Fmarinn-123/HALO/ESMRMB_poster 2.pdf

OBJECTIVES

# HALO: AN ULTRA LOW COST GRADIENT AMPLIFIER FOR LOW FIELD MRI

INTRODUCTION

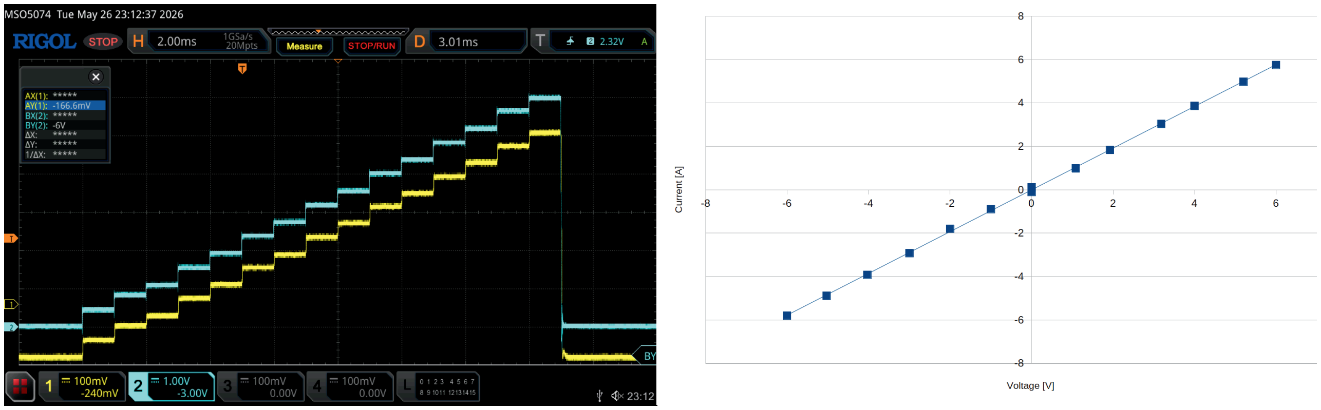
[picture p1: figure]

RESULTS

Felipe Marín | Belén Bravo-Kunz | Clemente Soza
1,2 | 1,2 | 1,2
Carlos Milovic | Cristian Tejos | Pablo Irarrázaval
1,2 | 1,2,3 | 1,2,3,4
Department of Electrical Engineering, Pontificia Universidad Católica de Chile

1
Biomedical Imaging Center, Pontificia Universidad Católica de Chile

2
Millennium Institute for Intelligent Healthcare Engineering, Pontificia Universidad Católica de Chile

3
Institute for Biological and Medical Engineering, Pontificia Universidad Católica de Chile

4

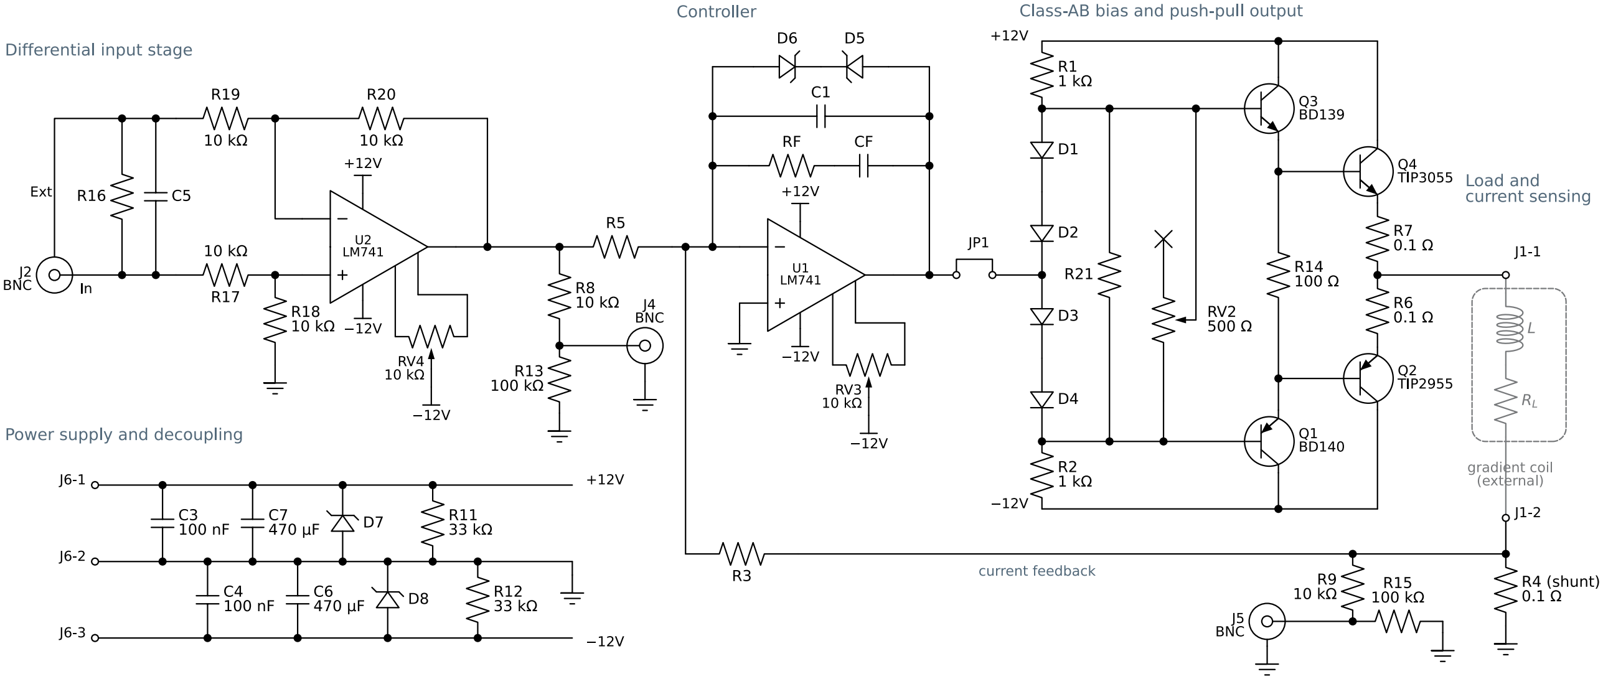
[picture p2: figure]
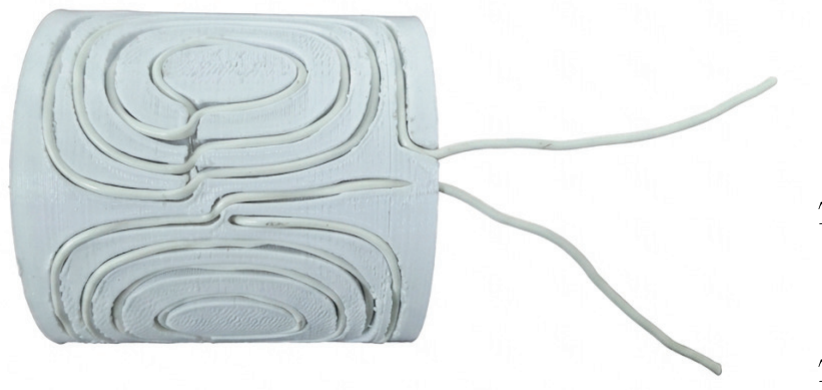
[picture p3: figure]

Acknowledgements. This study was supported by ANID – Millennium Science Initiative Program ICN2021_004 (iHEALTH) and Fondecit 1231535

Halbach low-field scanners lower cost, but accessible systems also require affordable, reproducible electronics.
Commercial gradient amplifiers exceed the power and cost needs of small, passively cooled coils. Open-source designs (e.g., OSII [1]) target higher currents and add monitoring and protection stages,
increasing cost and complexity.
Aim: a gradient amplifier under USD 100/channel that is simple, reproducible, locally manufacturable, and

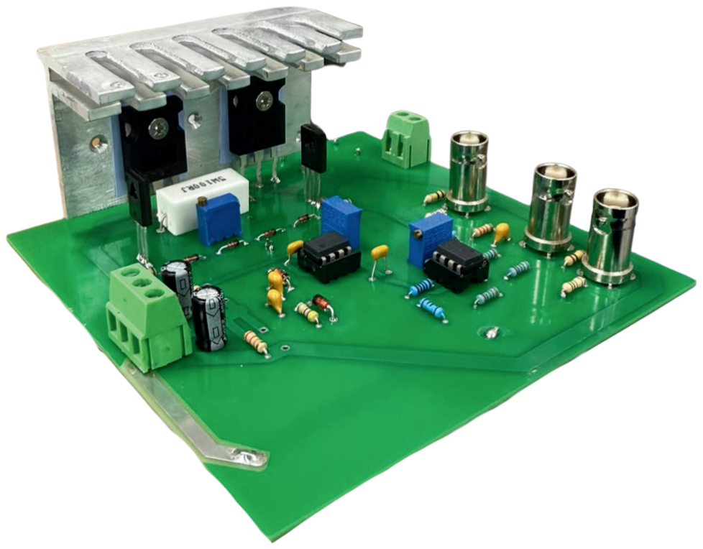
[picture p4: figure]

suited to low-field, small-FOV MRI. | Figure 1: Single-channel amplifier circuit
METHODS | RESULTS

Design requirements and architecture
- Load: Gradient coils (0.2 Ω, 10 μH, 5 mT/(m·A)) driven with trapezoids up
to ±6 A and 0.5 ms rise/fall times.
- Supply: ±12 V from two 12 V, 7 Ah batteries, avoiding ground noise, switching EMI and ripple.
- Controller: Closed-loop PI (UA741CP op-amp) following Evetts and Conradi [2], ensuring zero steady-state error on the RL load.
- Power stage: Class AB adapted from Self [3], providing symmetric bidirectional current, low distortion and low output impedance (Figs. 2–3).

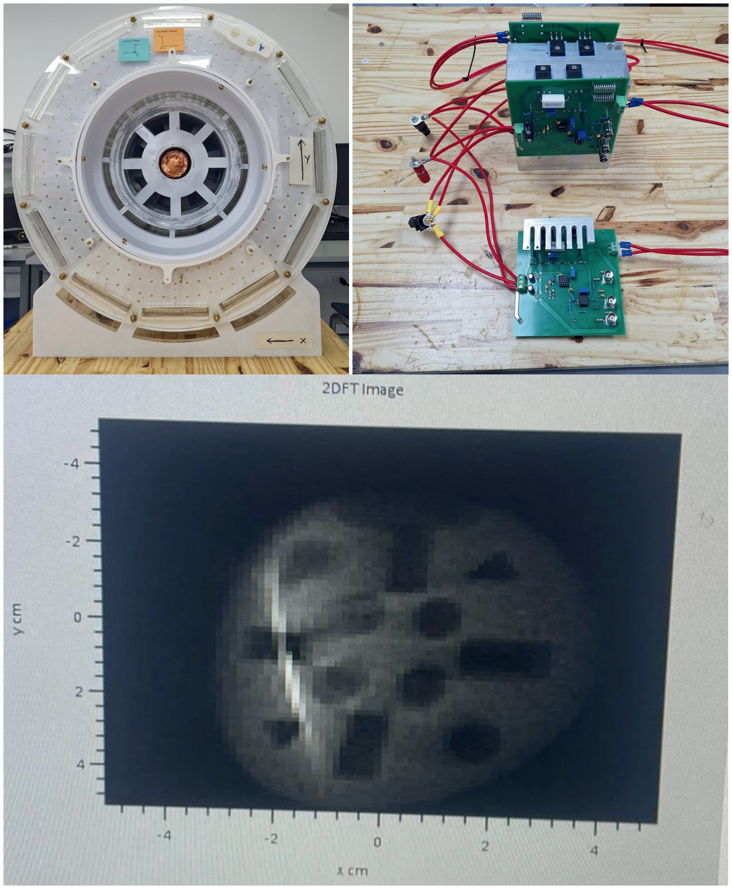
[picture p5: figure]

CONCLUSIONS

REFERENCES

[1] D. H. de Gans, Gradient Amplifier Design, Open Source Imaging Initiative design document, 2020.
[2] N. Evetts and M. S. Conradi, “Low-cost gradient amplifiers for small MRI systems,” Journal of Magnetic Resonance, vol. 335, 107127, 2022.
[3] D. Self, Audio Power Amplifier Design, 6th ed., Focal Press, 2013.

Contact: felipemarinegrete@uc.cl

Poster N° PG104

Power stage
- Current boost: Darlington class AB stage amplifying the op-amp's ~20 mA output.
- Output transistors: TIP3055/TIP2955 (15 A, 90 W) driven by a BD139/BD140 pair.
- Bias: Four 1N4148 diodes, adjusted with RV2.
Controller tuning
- Transfer functions: Controller Eq. (1) yielding closed loop Eq. (2), reduced to Eq. (3) when C R = L/R . f f L
- Bandwidth: At least 10 kHz, targeted for tracking 0.5 ms ramps.
- Closed-loop design tool on github repository (see QR code).

Figure 2: Implemented circuit schematic

Figure 4: Stepped current response (Cyan: voltage input; yellow: measured output current) and current-voltage linear fit

Linearity: Tested
with current
staircases from 0 to
±6 A (Fig. 4).

Figure 7: 50 mT ERNIE setup and two oil tubes results

Figure 6: 46 mT Halbach setup and oil phantom results

Rise time: Measured at 0.06 ms for a 6 A step (30 mT/m) against a 0.5 ms target (Fig. 5), enabling faster switching, shorter readouts and less offresonance.

Construction: Built from local through-hole parts on a simplified PCB for about USD 70/channel (about USD 210 for 3 axes).

MRI integration: Tested with three amplifiers on a shared ±12 V battery pack driving the x/y/z coils of an in-house 46 mT Halbach scanner, imaging an oil phantom (Fig. 6).

ERNIE: Integrated into the CAMERA-IMAGINE educational toolkit (piloted at the
ESMRMB | 2025 | Workshop), | yielding
gradient-encoded phantom images (Fig. 7) and showing readiness for open educational platforms.

Limitation: Tuning of the PI controller required for each load and target bandwidth; a design tool for choosing the parameters is available on GitHub, together with the rest of the project files (see QR code).

Figure 5: Circuit response to a 6 A step with 0.06 ms rise time.

Figure 3: Gradient coil used as circuit load and the closed-loop control equations

Costs under USD 100/channel for low-field MRI.
Provides linear current control, delivering ±6 A at 0.1 A/μs (500 T/m/s) into 0.2 Ω, 10 μH.
Integrates into a 46 mT Halbach scanner and into ERNIE.
Offers a simple, reproducible route to accessible gradient hardware.
