Fmarinn-123/HALO/Spice/BJT V1.5.asc

C1: cap; 10p
C3: cap; 100n
CF: cap; 2.26n
D1: diode
D2: diode
D3: diode; UFZV11B
D4: diode; UFZV11B
D5: diode
D6: diode
L1: ind; 25µ; Rser=1m
Q1: npn; Qtip3055
Q2: pnp; Qtip2955
Q3: npn; Qbd139
Q4: pnp; Qbd140
R1: res; 120
R2: res; 0.1
R3: res; 50
R4: res; 0.1
R5: res; 100
R6: res; 10k
R8: res; 10k
R9: res; 0.1
R10: res; 10k
R11: res; 1k
R12: res; 0.2
R13: res; 10k
R14: res; 10k
R15: res; 1k
R16: res; 1k
RF: res; 27.7k
U1: opamp2; UA741
U2: opamp2; UA741
V2: voltage; 12
V3: voltage; -12
V4: voltage; PULSE(0 6 0.1m 0.06m 0.06m 0.1m 10m 1)
Named nets: VCC1, VEE1, 0
.tran 2m
.include "models\\UA741.lib"
.include "models\\TIP2955.LIB"
.include "models\\TIP3055.LIB"
.include "models\\bd140.lib"
.include "models\\bd139.lib"
