Fmarinn-123/HALO/(commit log)

2026-05-27 Refactor Feedback_Poles.py for polynomial visualization
    This script visualizes the characteristic polynomial of a closed-loop control system after pole-zero cancellation. It includes sliders for real-time tuning of circuit parameters and updates the polynomial and its roots accordingly.
2026-09-21 Kicad Proyect
    Schematic and PCB routing.
2026-09-21 Update Feedback_Poles.py
    Enhanced the feedback pole visualizer with additional sliders and controls for new parameters, including inductance and load resistance. Improved the layout and interaction for better user experience.
2026-09-24 Schematic, and closed loop equations
2026-09-24 Add Schematic.svg file
2026-09-24 Revise README for gradient-amplifier terminology
    Updated README to reflect changes in variable names and descriptions related to the gradient-amplifier current loop.
2026-10-02 Update circuit models section in Readme
    Clarified gain relationship and feedback impedance in circuit models section.
2026-10-02 Update description of `R21` in Readme.MD
    Clarify the role of `R21` as an auxiliary resistor and its relation to `Rv2` in bias voltage adjustment.
2026-10-03 Update gradient coil nd shunt resistor explanation
    Clarified description of gradient coil and shunt resistor behavior in the Readme.
